nikitalita/MU80-DIT/readme.md

WARNING: WORK IN PROGRESS, COMPLETELY UNTESTED

From https://kurohane.net/wiki/index.php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
