nikitalita/MU80-DIT/74FST3257/eec.models/On_Semiconductor_-_74FST3257DTR2G.step

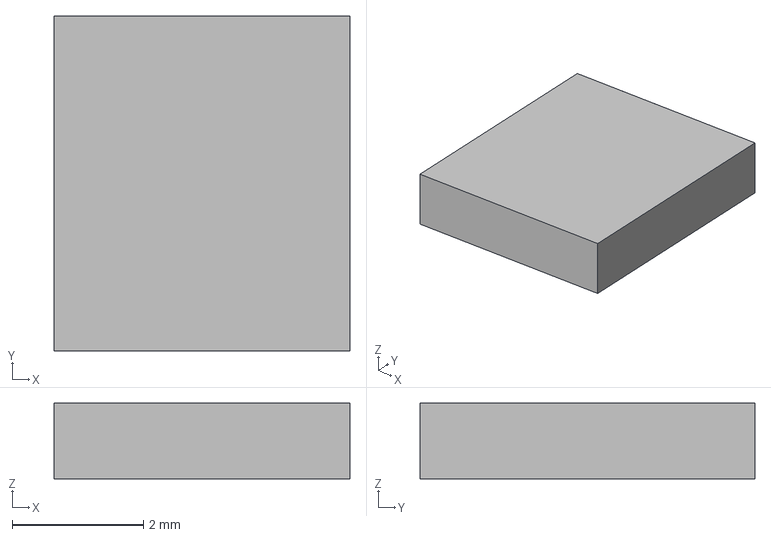
[picture p1: CAD file, 2022-07-04]
74FST3257/eec.models/On_Semiconductor_-_74FST3257DTR2G.step
4.50 x 5.10 x 1.15 mm
