nikitalita/MU80-DIT/footprints/User Library-GP1FAV50TK_e_1.STEP

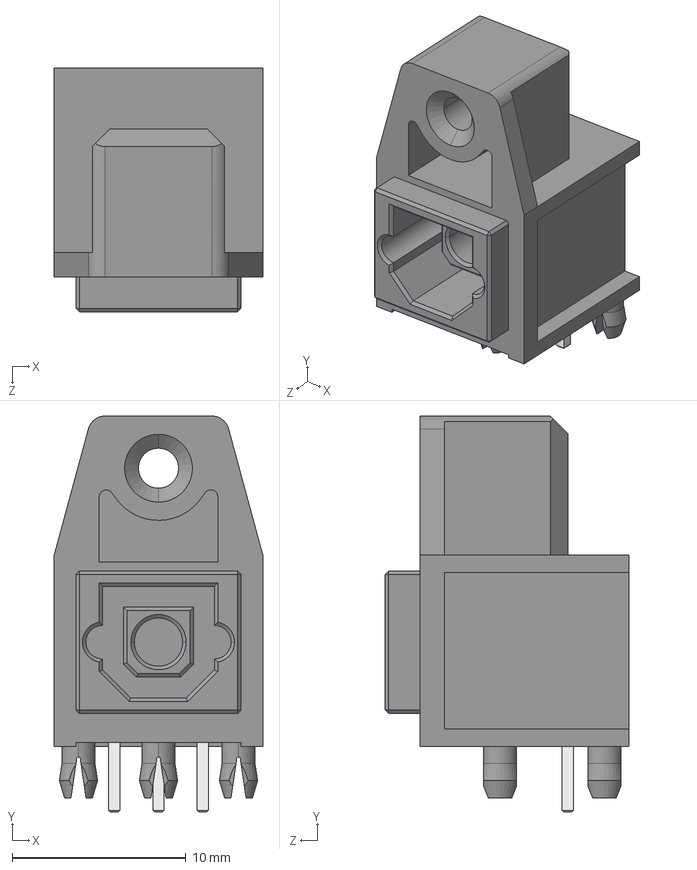
[picture p2: CAD file, 2022-07-04]
footprints/User Library-GP1FAV50TK_e_1.STEP
12.0 x 22.8 x 14.0 mm
