nikitalita/MU80-DIT/NB3L553/NB3L553DG.step

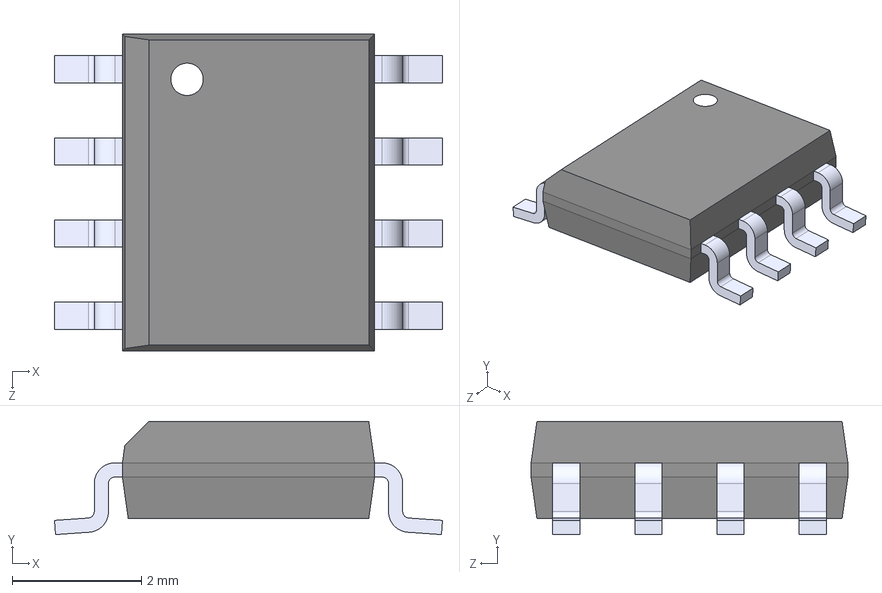
[picture p3: CAD file, 2022-07-04]
NB3L553/NB3L553DG.step
6.00 x 1.75 x 4.90 mm
