nikitalita/MU80-DIT/WM8804/eec.models/Cirrus_Logic_Inc._-_WM8804.step

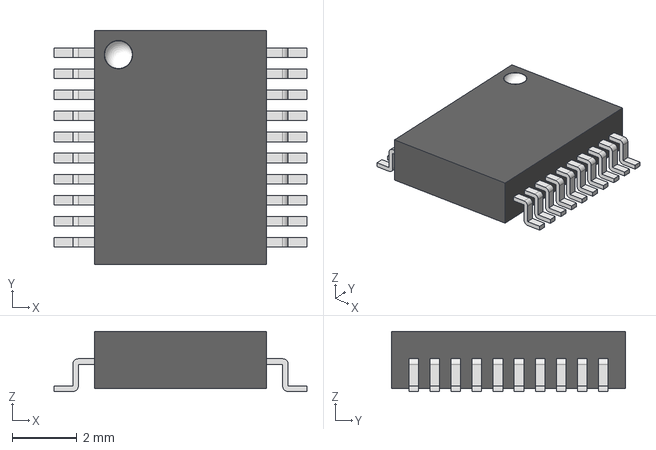
[picture p4: CAD file, 2022-07-04]
WM8804/eec.models/Cirrus_Logic_Inc._-_WM8804.step
7.80 x 7.20 x 1.85 mm
