nikitalita/MU80-DIT/footprints/User Library-TORX147L-1.STEP

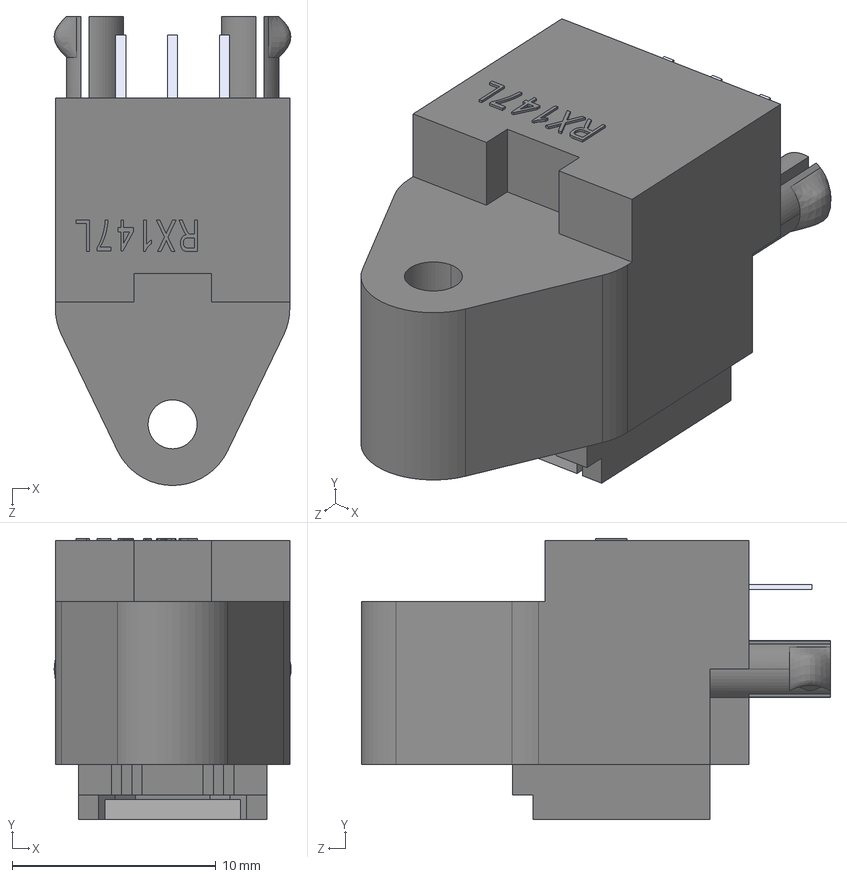
[picture p5: CAD file, 2022-07-04]
footprints/User Library-TORX147L-1.STEP
11.6 x 13.8 x 23.0 mm
