nikitalita/MU80-DIT/footprints/SOIC127P1030X265-16N.step

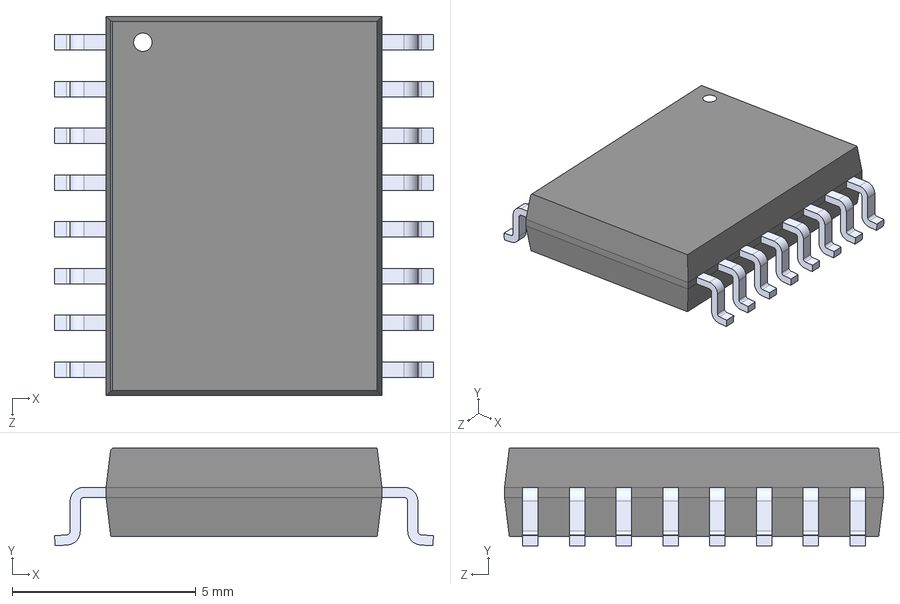
[picture p6: CAD file, 2022-07-04]
footprints/SOIC127P1030X265-16N.step
10.3 x 2.65 x 10.3 mm
