nikitalita/MU80-DIT/mu80-dit.kicad_pcb

## KiCad design mu80-dit.kicad_pcb (2022-07-04)

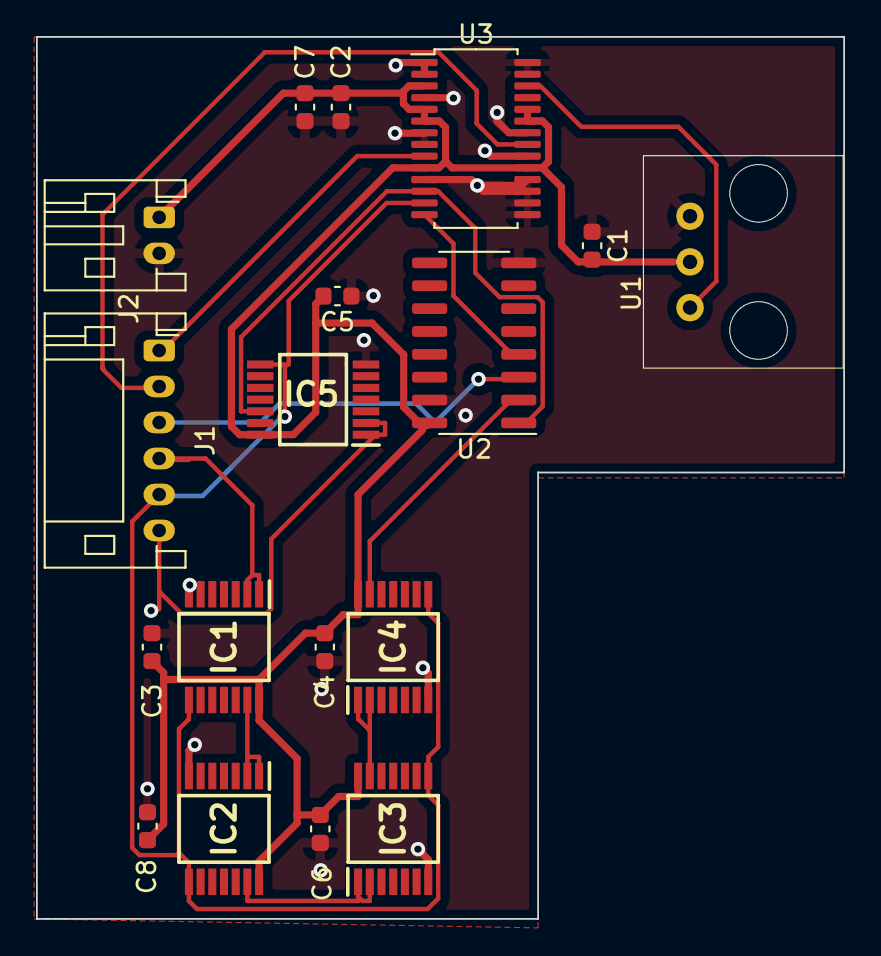
[picture p7: board mu80-dit.kicad_pcb from above]

Board: 2 copper layers, 44.8 x 49.0 mm, 18 parts (0 on the bottom side), 15 nets.

Parts:
C1, C2, C3, C4, C5, C6, C7, C8: 0.1u/35V; C_0603_1608Metric
IC1, IC2, IC3, IC4, IC5: 74AHC164PW,118; SOP65P640X110-14N
J1: Conn_01x06_Male; JST_PH_S6B-PH-K_1x06_P2.00mm_Horizontal
J2: Conn_01x02_Male; JST_PH_S2B-PH-K_1x02_P2.00mm_Horizontal
U1: TOTX-177L; Toshiba_TOTX177
U2: 74FST3257DTR2G; SOIC-16_3.9x9.9mm_P1.27mm
U3: CS8406; TSSOP-28_4.4x9.7mm_P0.65mm

Connections:
+5V: C1.2, C2.2, C3.2, C4.2, C5.2, C6.2, C7.2, C8.2, IC1.14 (VCC), IC2.14 (VCC), IC3.14 (VCC), IC4.14 (VCC), IC5.14 (VCC), J2.1, U1.2 (VCC), U2.16 (VCC), U3.3 (AD2/~EMPH), U3.5 (TSTN/SFMT1), U3.6 (VD), U3.10 (TEST/APMS), U3.19 (INT/~AUDIO), U3.23 (VL), U3.24 (H/~S)
/BICK: IC1.8 (CP), IC2.8 (CP), IC3.8 (CP), IC4.8 (CP), IC5.8 (CP), J1.5, U3.13 (ISCLK)
/LRCK: IC5.1 (DSA), IC5.2 (DSB), J1.6
/LSI: J1.3, U2.3 (1B2)
/MCLK: J1.2, U3.21 (OMCK)
/RESET: J1.1, U3.9 (~RST)
/RSI: IC1.1 (DSA), IC1.2 (DSB), J1.4
/SDAT: U2.4 (1A), U3.14 (SDIN)
/SHIFT_LRCK: IC5.12 (Q6), U2.1 (S), U3.12 (ILRCK)
/SHIFT_RSI: IC4.13 (Q7), U2.2 (1B1)
/TXP: U1.1 (GND), U3.26 (TXP)
GND: C1.1, C2.1, C3.1, C4.1, C5.1, C6.1, C7.1, C8.1, IC1.7 (GND), IC2.7 (GND), IC3.7 (GND), IC4.7 (GND), IC5.7 (GND), J2.2, U1.3 (Input), U2.8 (GND), U2.15 (~OE), U3.1 (SDA/CDOUT/COPY/C), U3.2 (AD0/~CS/TEST), U3.4 (RXP/SFMT0), U3.7 (TEST), U3.8 (TEST), U3.11 (TEST/TCBLD), U3.15 (TCBL), U3.16 (TEST/CEN), U3.17 (TEST/U), U3.18 (TEST/V), U3.20 (U/HWCK0), U3.22 (GND), U3.27 (AD1/CDIN/HWCK1), U3.28 (SCL/CCLK/ORIG)
unnamed: IC1.13 (Q7), IC2.1 (DSA), IC2.2 (DSB)
unnamed: IC2.13 (Q7), IC3.1 (DSA), IC3.2 (DSB)
unnamed: IC3.13 (Q7), IC4.1 (DSA), IC4.2 (DSB)
