nikitalita/MU80-DIT/(commit log)

2022-07-04 add project files
    [Cirrus_Logic_Inc._-_WM8804.step, NB3L553DG.step, On_Semiconductor_-_74FST3257DTR2G.step, SOIC127P1030X265-16N.step, User Library-GP1FAV50TK_e_1.STEP, User Library-TORX147L-1.STEP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]
2023-02-08 update flipflop part
    [mu80-dit.kicad_sch]
